LuisAndres-bot/Luis_Gonzalez_PLC4uni/Tarea 5/WhatsApp Image 2025-12-12 at 9.19.16 AM.jpeg

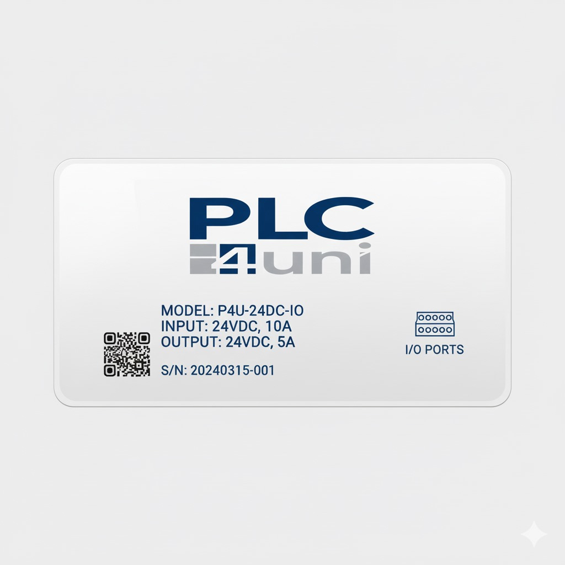
Tarea 5/WhatsApp Image 2025-12-12 at 9.19.16 AM.jpeg
