LuisAndres-bot/Luis_Gonzalez_PLC4uni/Tarea 6/WhatsApp Image 2025-12-12 at 9.21.24 AM (1).jpeg

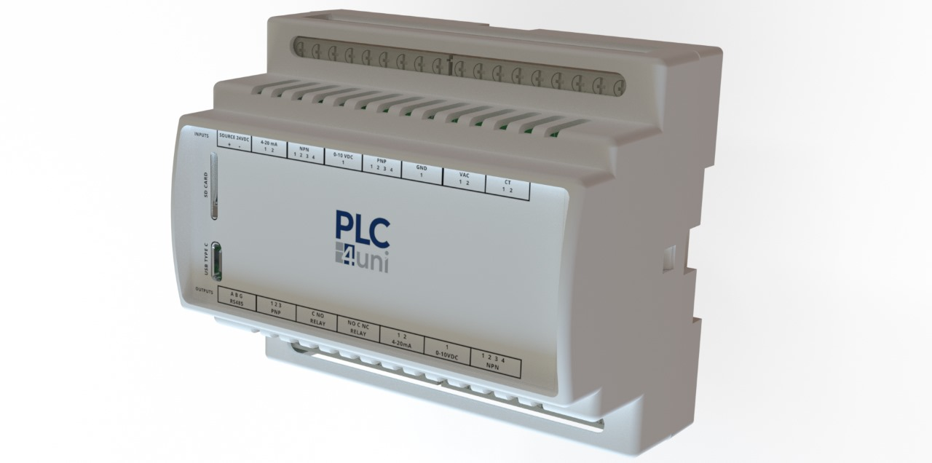
Tarea 6/WhatsApp Image 2025-12-12 at 9.21.24 AM (1).jpeg
