LuisAndres-bot/Luis_Gonzalez_PLC4uni/Tarea 2/Diseño de Freecad Caja para PLC Ensamble.FCStd

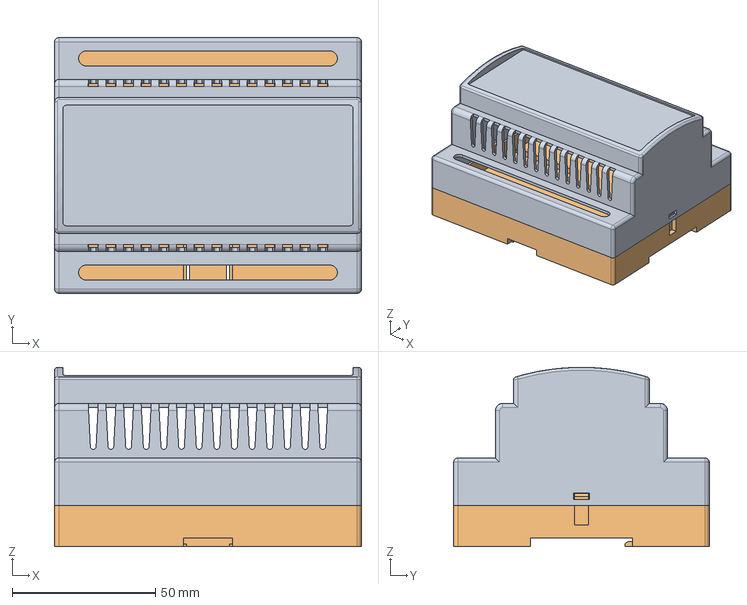
[picture p5: CAD file, 2025-09-26]
Tarea 2/Diseño de Freecad Caja para PLC Ensamble.FCStd
107.0 x 89.1 x 62.5 mm
