LuisAndres-bot/Luis_Gonzalez_PLC4uni/Tarea 4/PLC4uni Ensamble.FCStd

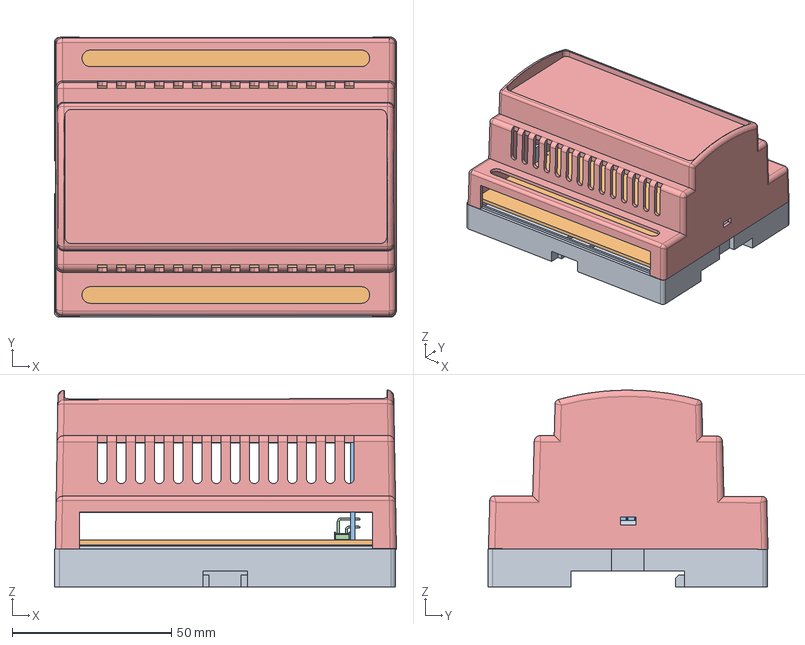
[picture p6: CAD file, 2025-12-12]
Tarea 4/PLC4uni Ensamble.FCStd
107.2 x 87.8 x 61.7 mm
PLC–4–UNI–209 Luis_001
PLC4uni PCB_001
PLC4uni PCB_Vertical_001
2x5 male PIn Header Angle_001
PLC Part-1_001
