LuisAndres-bot/Luis_Gonzalez_PLC4uni/PLC4UNI_Luis A. G/Diagramas_PLC4UNI_Dev_Board/PCBPLC4UNI.FCStd

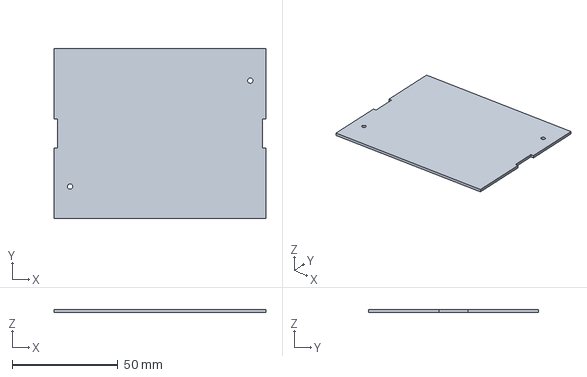
[picture p7: CAD file, 2025-12-12]
PLC4UNI_Luis A. G/Diagramas_PLC4UNI_Dev_Board/PCBPLC4UNI.FCStd
100.0 x 80.2 x 1.51 mm
