LuisAndres-bot/Luis_Gonzalez_PLC4uni/Tarea 4/PCB Vertical.DXF

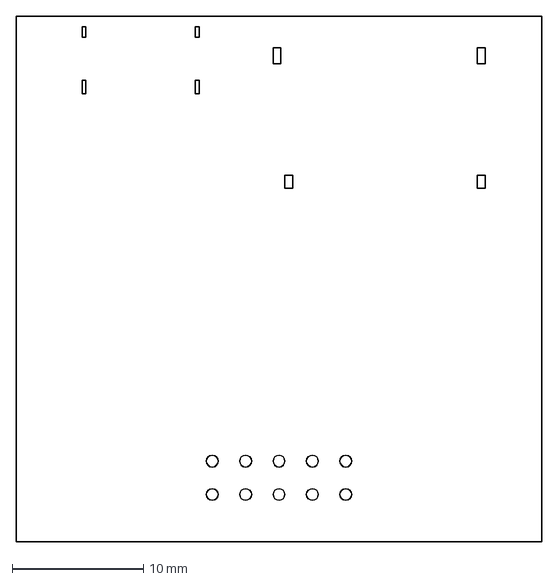
[picture p8: CAD file, 2025-12-12]
Tarea 4/PCB Vertical.DXF
40.0 x 40.0 mm
