LuisAndres-bot/Luis_Gonzalez_PLC4uni/Tarea 6/USB Type C Port (SMD Type) (1)[1].STEP

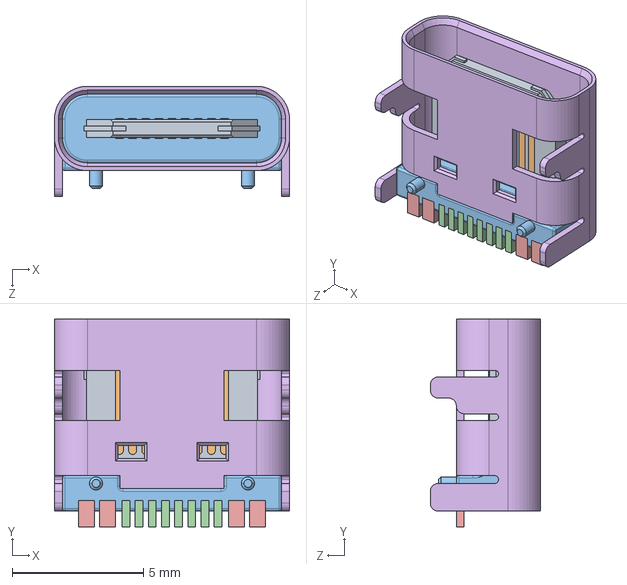
[picture p9: CAD file, 2025-12-12]
Tarea 6/USB Type C Port (SMD Type) (1)[1].STEP
8.94 x 7.90 x 4.20 mm
