LuisAndres-bot/Luis_Gonzalez_PLC4uni/PLC4UNI_Luis A. G/Diagramas_PLC4UNI_Dev_Board/PIN2x5.FCStd

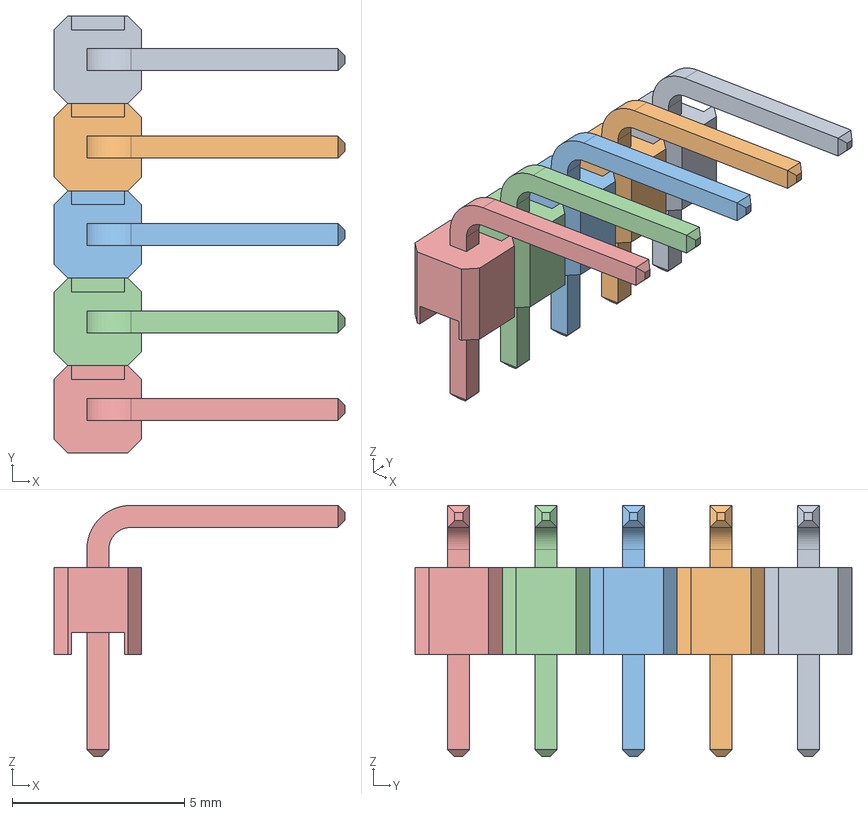
[picture p10: CAD file, 2025-12-12]
PLC4UNI_Luis A. G/Diagramas_PLC4UNI_Dev_Board/PIN2x5.FCStd
8.45 x 12.7 x 7.30 mm
