LuisAndres-bot/Luis_Gonzalez_PLC4uni/Tarea 4/2x5 Male Pin Header AngleLuis.STEP

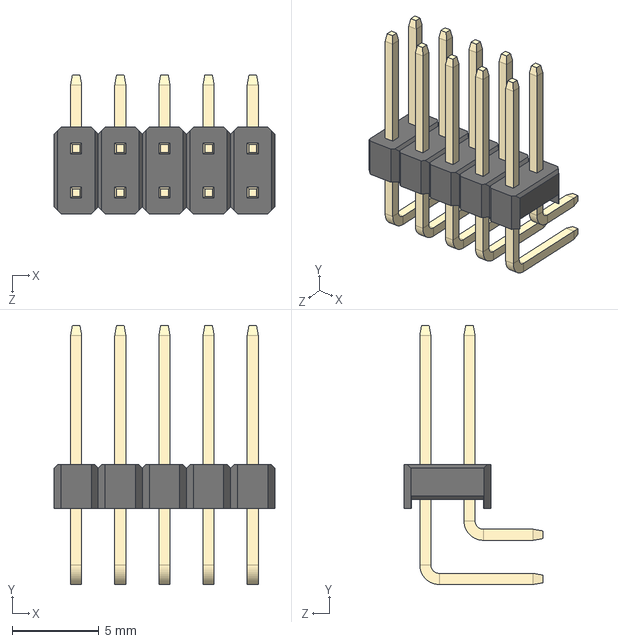
[picture p11: CAD file, 2025-12-12]
Tarea 4/2x5 Male Pin Header AngleLuis.STEP
12.7 x 14.9 x 8.00 mm
