LuisAndres-bot/Luis_Gonzalez_PLC4uni/Tarea 4/Same_Sky_MSD-4-A (1).step

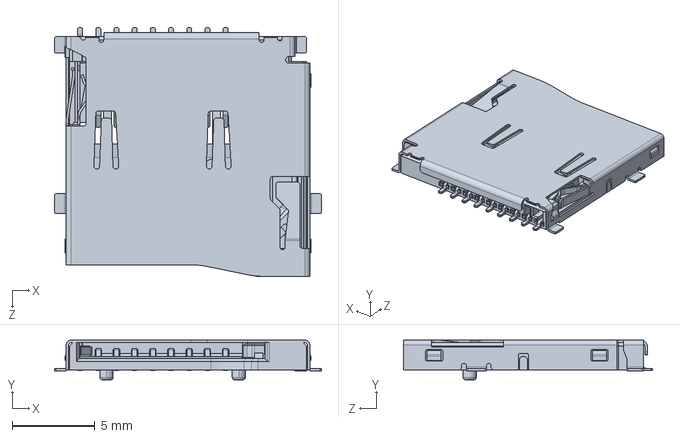
[picture p12: CAD file, 2025-12-12]
Tarea 4/Same_Sky_MSD-4-A (1).step
16.1 x 2.40 x 15.0 mm
