LuisAndres-bot/Luis_Gonzalez_PLC4uni/(list of files, cad)

Other CAD files:
PLC4UNI_Luis A. G/Diagramas_PLC4UNI_Dev_Board/PLC4UNIPCB.step
