LuisAndres-bot/Luis_Gonzalez_PLC4uni/PLC4UNIPCB/Entrada 3.3.kicad_sch

## KiCad design PLC4UNIPCB/Entrada 3.3.kicad_sch (2025-11-14)

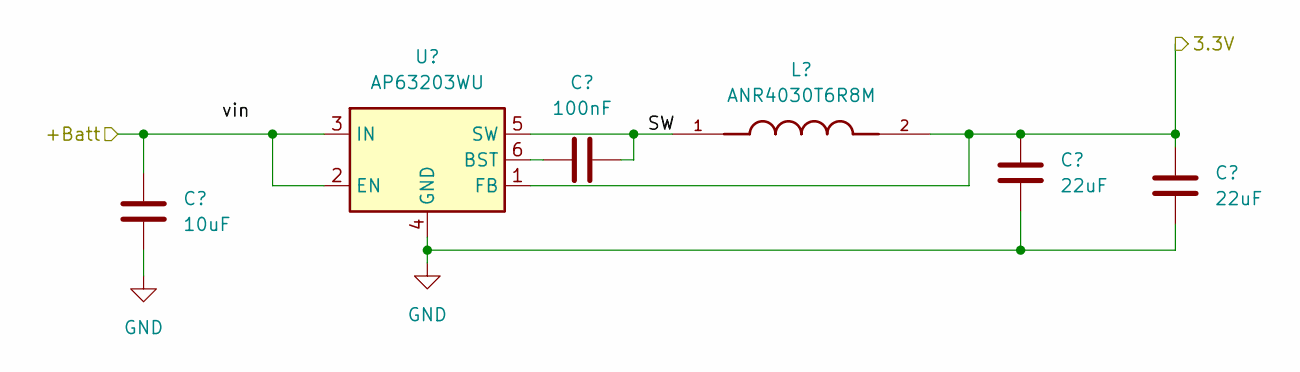
[picture p14: schematic Entrada 3.3.kicad_sch]

Parts:
C22: 10uF; C_1206_3216Metric; LCSC C89632
C23: 100nF; C_0805_2012Metric; LCSC C519980
C24, C25: 22uF; C_1206_3216Metric; LCSC C7472972
L5: ANR4030T6R8M; L_APV_ANR4030; LCSC C77758
U3: AP63203WU; TSOT-23-6

Connections:
3.3V: C24.1, C25.1, L5.2, U3.1 (FB)
+Batt: C22.1, U3.2 (EN), U3.3 (IN)
GND: C22.2, C24.2, C25.2, U3.4 (GND)
unnamed: C23.1, U3.6 (BST)
SW: C23.2, L5.1, U3.5 (SW)
